stvenmobile/mecca_ws/stl_files/README.md

This directory contains STL files for 3D printing the Mecca robot cab.
