stvenmobile/mecca_ws/images/20250301_160927.jpg

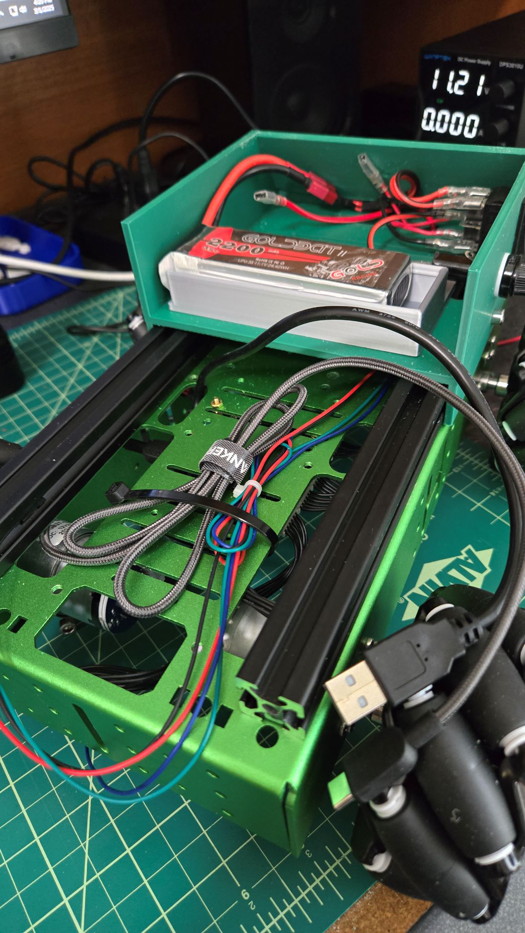
images/20250301_160927.jpg
