stvenmobile/mecca_ws/images/20250304_111006.png

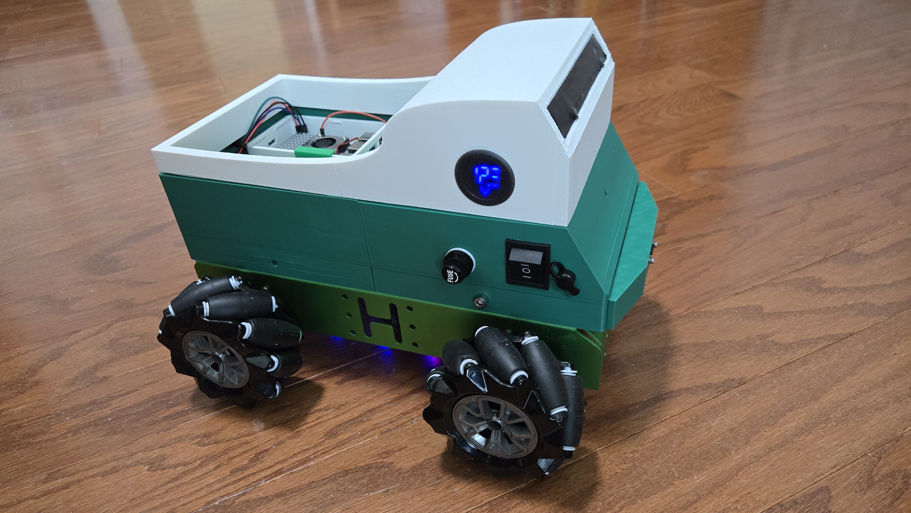
images/20250304_111006.png
