stvenmobile/mecca_ws/stl_files/mecca robot cab v1.png

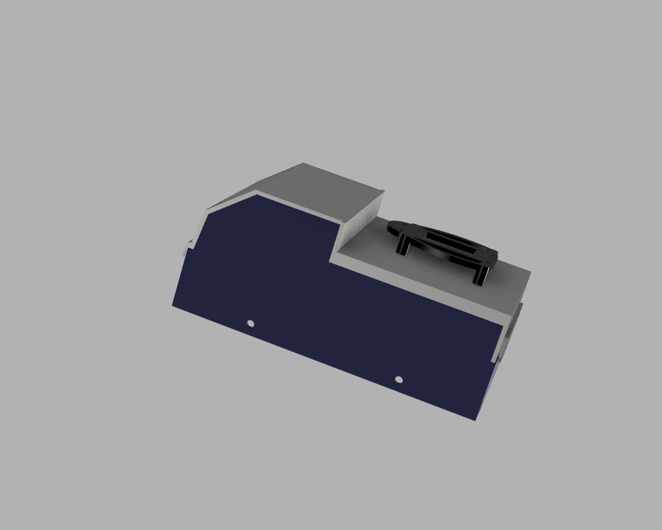
stl_files/mecca robot cab v1.png
