stvenmobile/mecca_ws/src/mecca_description/meshes/rl_wheel_link.stl

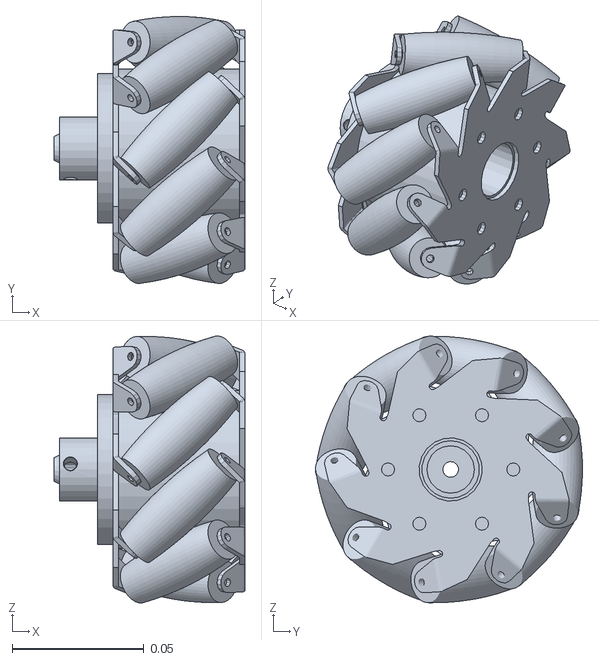
[picture p8: CAD file, 2025-05-01]
src/mecca_description/meshes/rl_wheel_link.stl
0.0724 x 0.101 x 0.101
