stvenmobile/mecca_ws/stl_files/Cab_Rear.stl

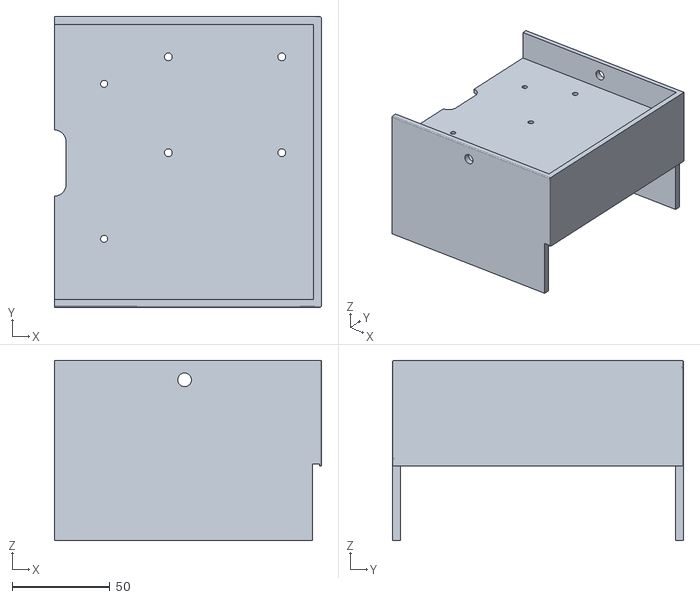
[picture p9: CAD file, 2025-03-14]
stl_files/Cab_Rear.stl
136.5 x 148.8 x 92.3
