stvenmobile/mecca_ws/src/mecca_description/meshes/chassis_rviz_bin.stl

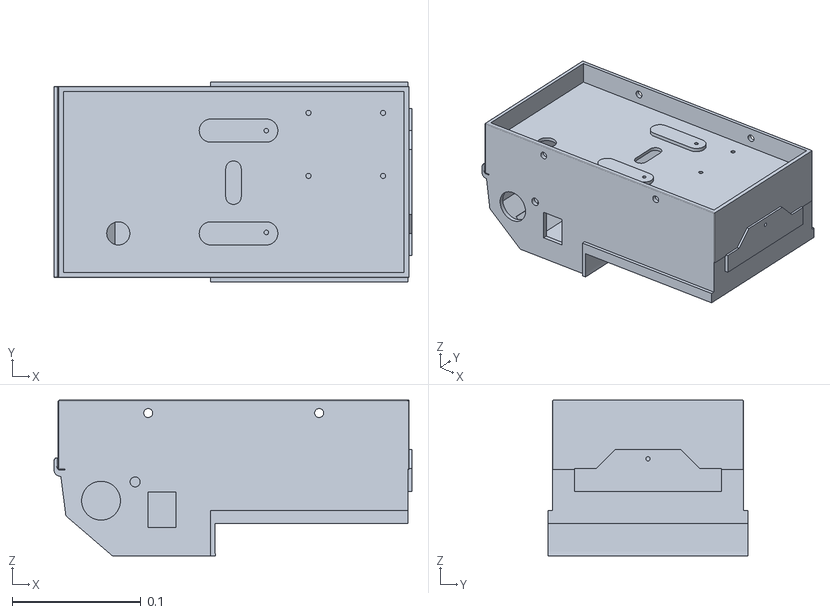
[picture p10: CAD file, 2025-05-01]
src/mecca_description/meshes/chassis_rviz_bin.stl
0.278 x 0.156 x 0.121
