stvenmobile/mecca_ws/stl_files/A1 RPLidar Mount.stl

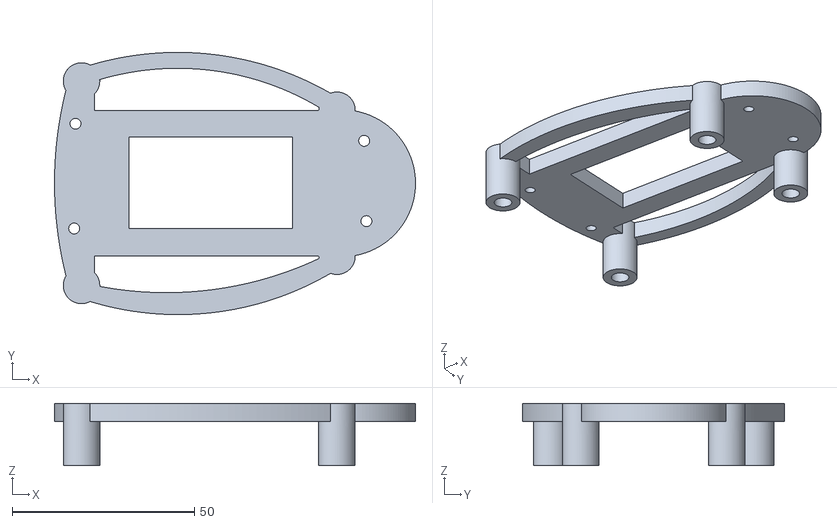
[picture p11: CAD file, 2025-03-14]
stl_files/A1 RPLidar Mount.stl
98.9 x 71.9 x 17.0
