stvenmobile/mecca_ws/stl_files/BattBox.stl

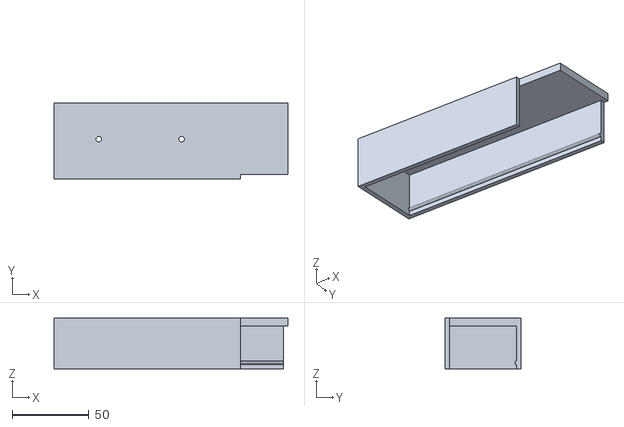
[picture p12: CAD file, 2025-03-14]
stl_files/BattBox.stl
152.0 x 49.6 x 33.0
