stvenmobile/mecca_ws/stl_files/Cab_Top.stl

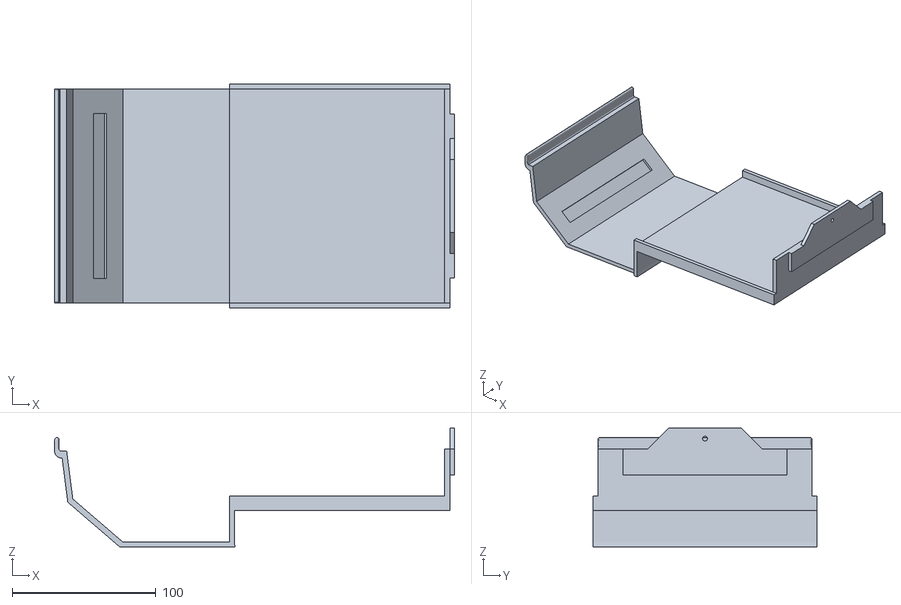
[picture p13: CAD file, 2025-03-14]
stl_files/Cab_Top.stl
278.5 x 155.6 x 82.7
