stvenmobile/mecca_ws/stl_files/mecca robot cab v1.3mf

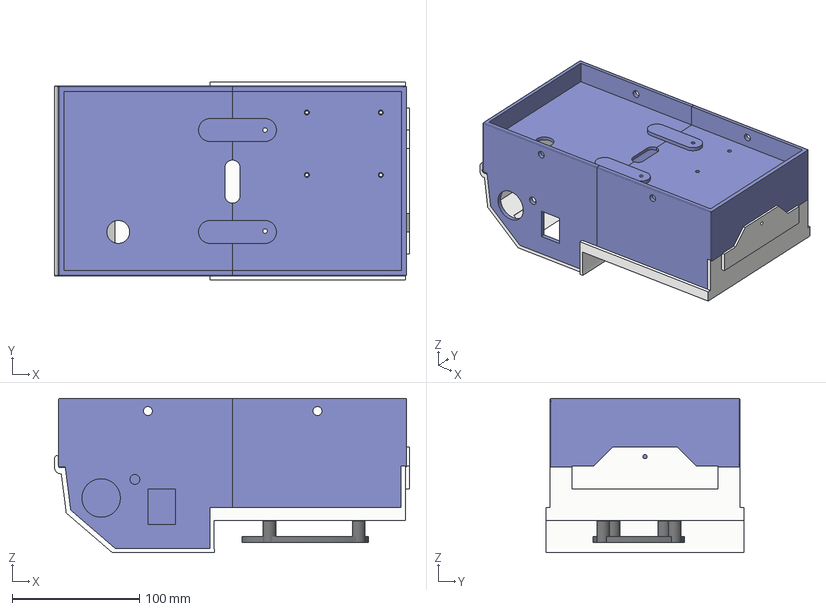
[picture p14: CAD file, 2025-03-14]
stl_files/mecca robot cab v1.3mf
278.5 x 155.6 x 121.1 mm
Boss-Extrude3
Cab_front
Cab_rear
Cab_top
