stvenmobile/mecca_ws/src/mecca_description/meshes/chassis_rviz_ascii.stl

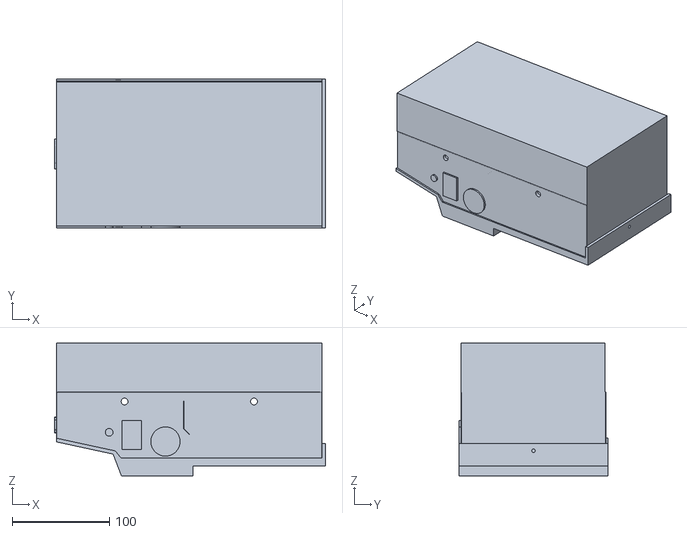
[picture p15: CAD file, 2025-05-01]
src/mecca_description/meshes/chassis_rviz_ascii.stl
278.4 x 152.8 x 136.4
