stvenmobile/mecca_ws/stl_files/Cab_Front.stl

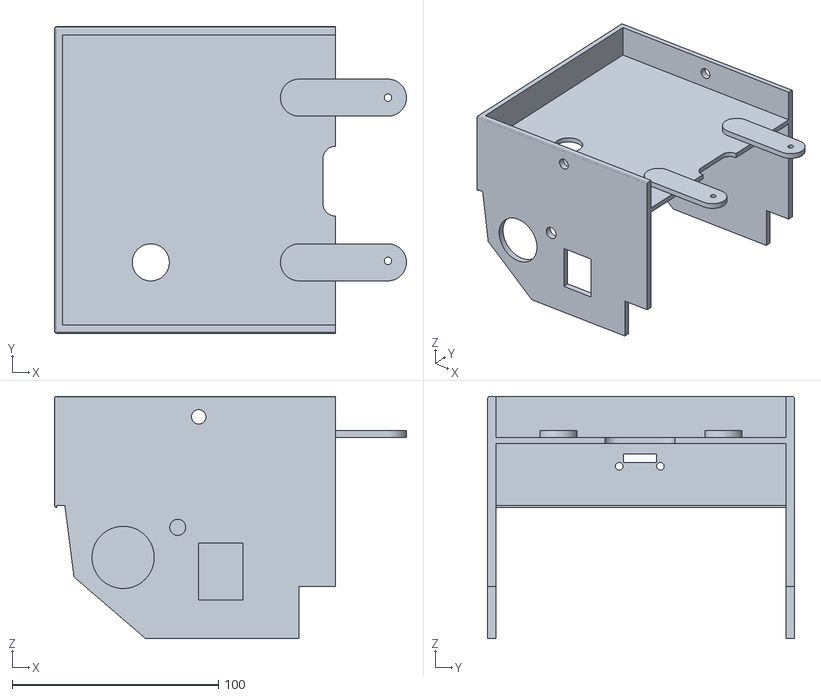
[picture p16: CAD file, 2025-03-14]
stl_files/Cab_Front.stl
170.9 x 148.8 x 117.7
