stvenmobile/mecca_ws/(list of files, cad)

Other CAD files:
src/mecca_description/meshes/rr_wheel_link.stl
src/mecca_description/meshes/fr_wheel_link.stl
src/mecca_description/meshes/fl_wheel_link.stl
