stvenmobile/mecca_ws/(commit log)

2025-02-28 Major changes to fix joystick config and mecca_driver_node.
    [mecca_driver_node.py]
2025-03-01 Version 1.0 - Comms problems resolved.
    [mecca_driver_node.py, simple_serial.py]
2025-03-07 V2.1 release - added backup beeper, PID tuning, Encoder data topic, fixed bugs
    [led_controller_node.py, mecca_driver_node.py, simple_serial.py]
2025-03-14 Added stl_files directory for 3D printing files
    [A1 RPLidar Mount.stl, BattBox.stl, Cab_Front.stl, Cab_Rear.stl, Cab_Top.stl, mecca robot cab v1.3mf]
2025-03-17 Updating URDF for Mecca.
    [mecanum.urdf]
2025-03-19 Minor fix for LED Sequences.
    [led_controller_node.py]
2025-05-01 Updated dev workspace structure for ROS2 Jazzy.
    [chassis_rviz_ascii.stl, chassis_rviz_bin.stl, fl_wheel_link.stl, fr_wheel_link.stl, gazebo_control.xacro, inertial_macros.xacro, mecanum.urdf, mecanum_controllers.yaml]
2025-05-01 updating with latest driver packages from physical robot
2025-05-05 Refined wheel orientation, joystick behavior, and removed deprecated packages
    [meccabot.xacro]
2025-05-05 fixing wheel orientation.
    [meccabot.xacro]
2025-05-06 Initial version of mecca_hardware_interface for ROS COntrol.
    [mecanum_controller.yaml, meccabot.xacro]
2025-05-08 working on hardware interface.
    [mecanum_controller.yaml, meccabot.xacro]
2025-05-08 hardware interface updates.
    [mecanum_controller.yaml]
2025-05-14 Minor updates to launch file
    [mecanum_controller.yaml, mecanum_controllers.yaml, mecanum_drive_controller.yaml, meccabot.xacro, ros2_control_node.yaml]
2025-05-23 Updated urdf, and minor cleanups.
    [meccabot.xacro]
